JS-RML/parrot_gripper/(commit log)

2021-10-02 Update Arduino Code
2021-10-11 Add odrive config
2021-11-11 Update schematic
2021-12-09 Add odrive configs
